fpernice518/Smart-Bike---Senior-Design/Pictures/DSC02479.JPG

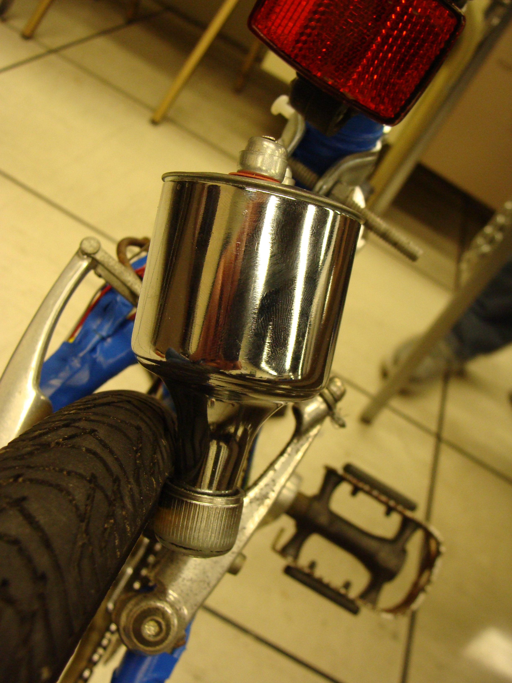
Pictures/DSC02479.JPG
