fpernice518/Smart-Bike---Senior-Design/Pictures/DSC02471.JPG

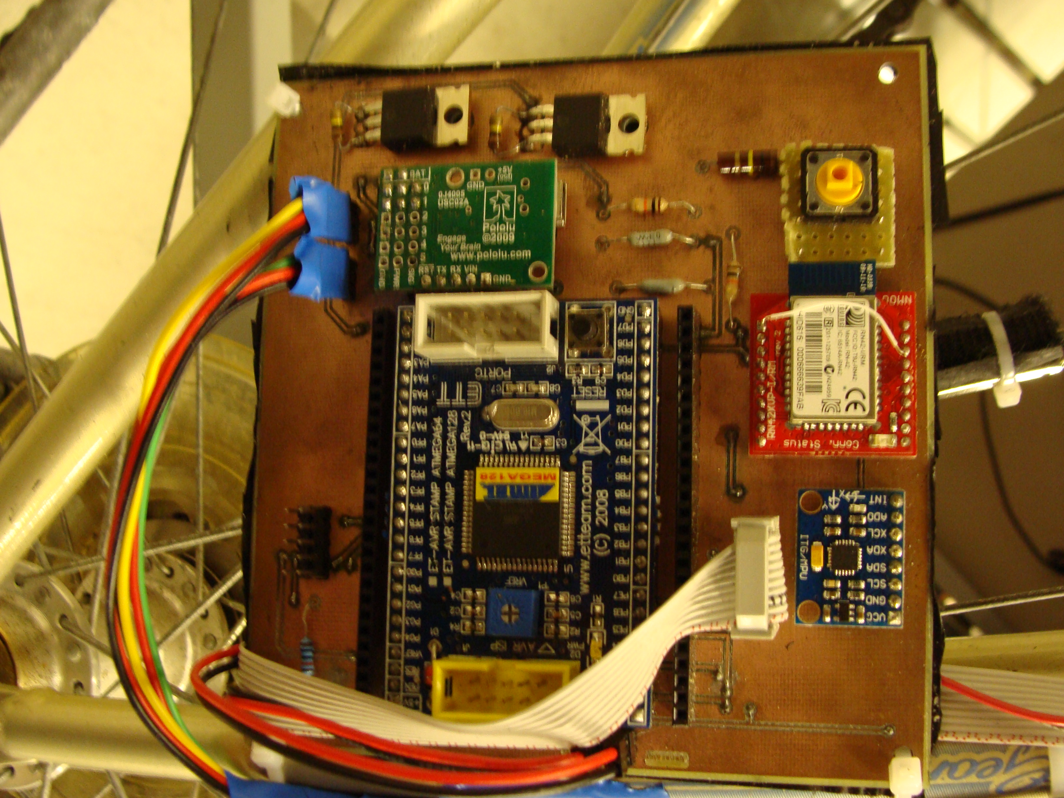
Pictures/DSC02471.JPG
