fpernice518/Smart-Bike---Senior-Design/Android App/README.txt

The included .apk file is the installer for Android phones.
This file should be place don an Android phone and installed
It can also be dowloaded from my website at:
http://frankpernice.com/Projects/SmartBike/SmartBike.apk
Or by scaning the included QR code with a Android phone's camera

The .aia file is the App Inventor file.
To view the block code, follow these steps:
1) visit ai2.appinventor.mit.edu/
2) sign in with a Google account
	- I suppose the school email will now be fine now that it is Gmail based.
3) At the main screen, click Project -> Import Project (.aia) from my computer
