fpernice518/Smart-Bike---Senior-Design/Pictures/DSC02470.JPG

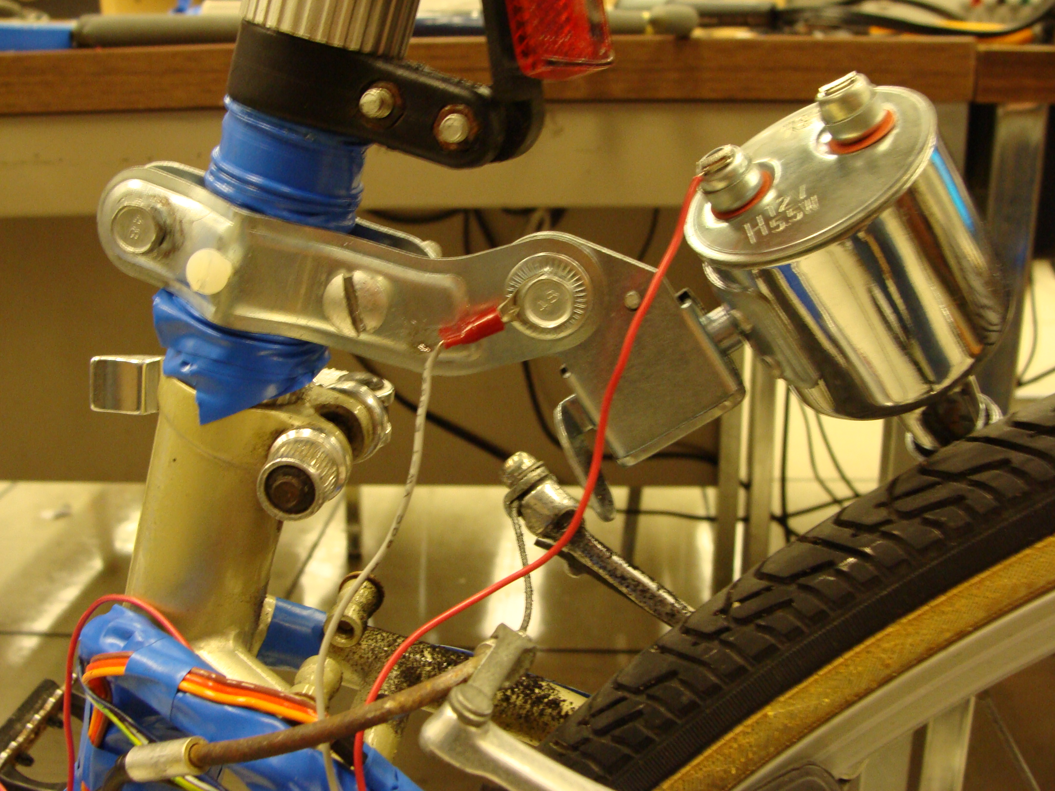
Pictures/DSC02470.JPG
