fpernice518/Smart-Bike---Senior-Design/Pictures/DSC02472.JPG

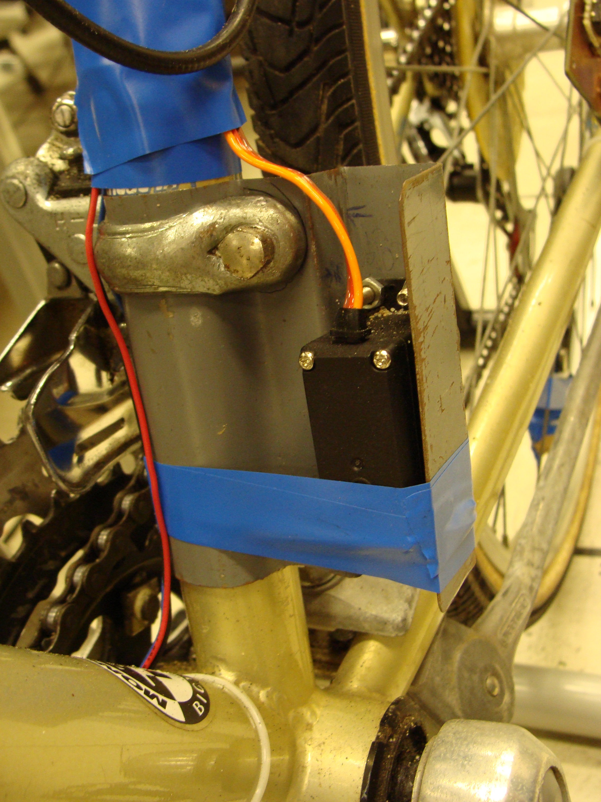
Pictures/DSC02472.JPG
