fpernice518/Smart-Bike---Senior-Design/Pictures/DSC02473.JPG

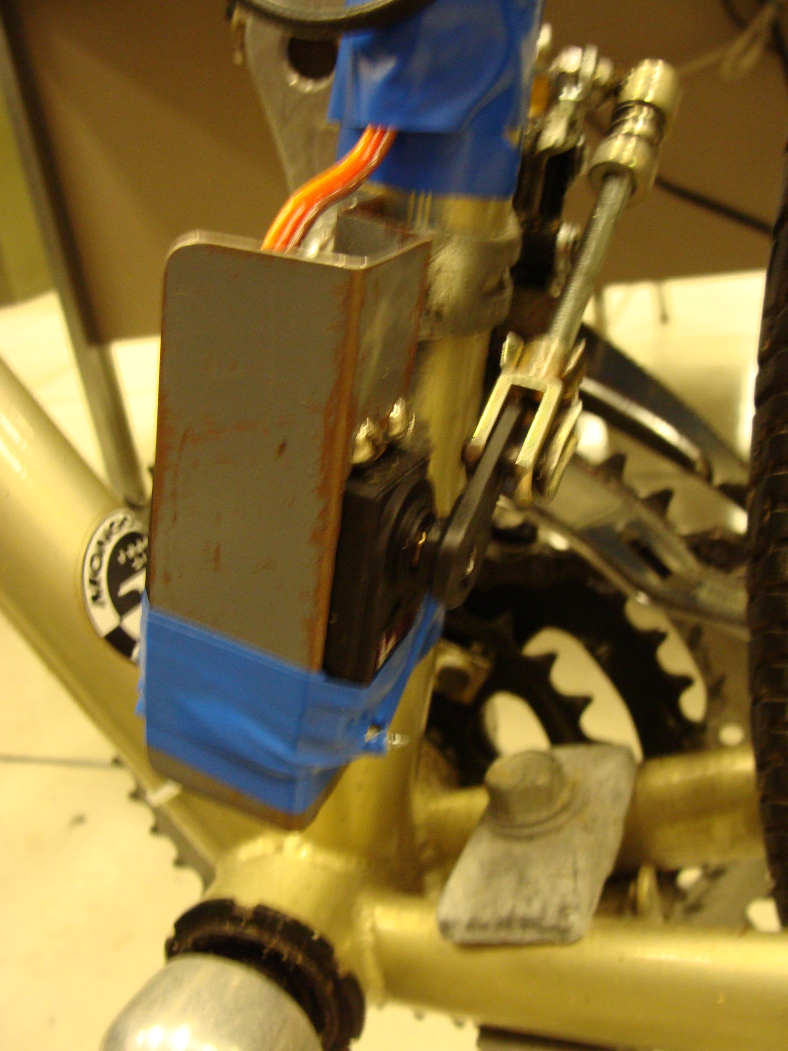
Pictures/DSC02473.JPG
