fpernice518/Smart-Bike---Senior-Design/Pictures/DSC02474.JPG

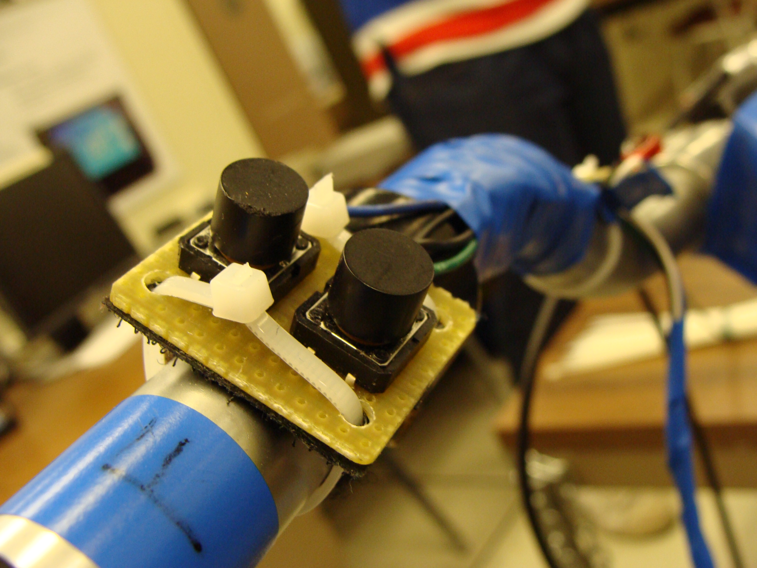
Pictures/DSC02474.JPG
