fpernice518/Smart-Bike---Senior-Design/Pictures/DSC02475.JPG

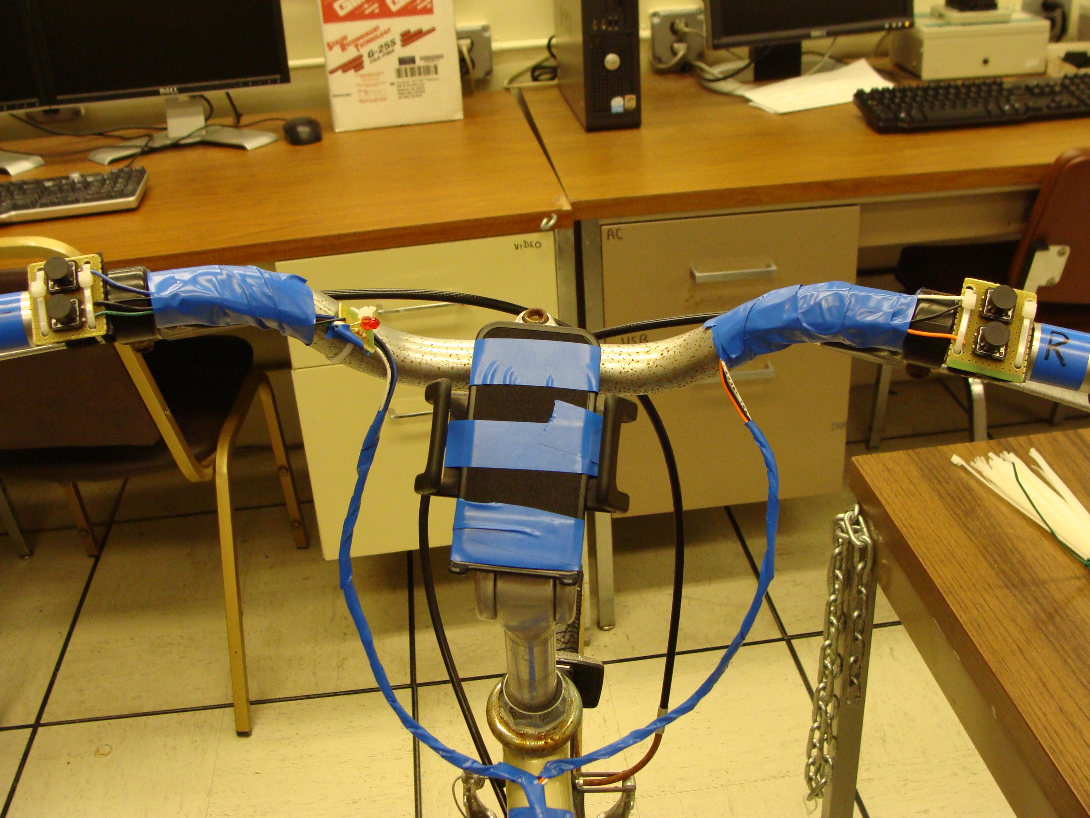
Pictures/DSC02475.JPG
