fpernice518/Smart-Bike---Senior-Design/Pictures/DSC02478.JPG

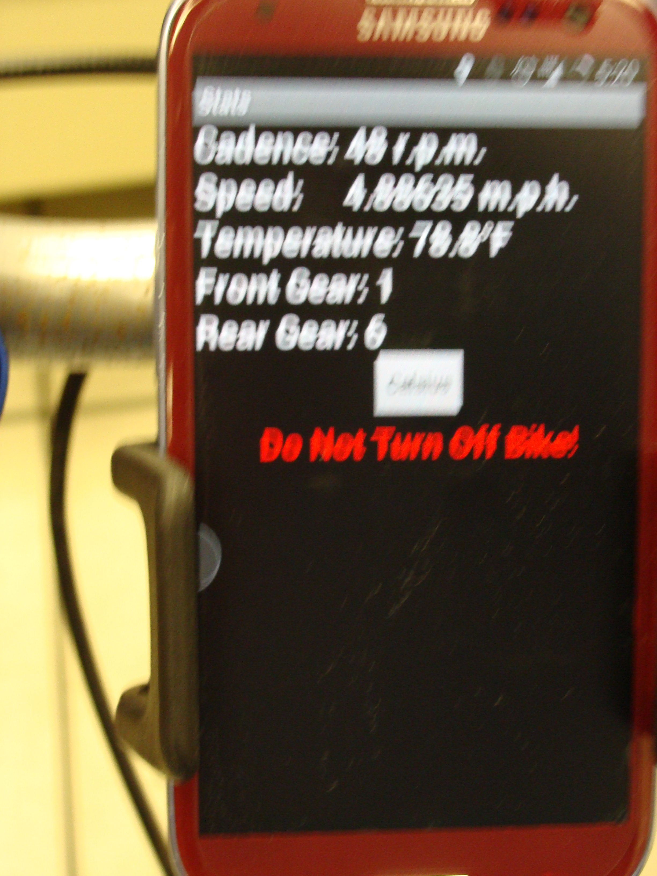
Pictures/DSC02478.JPG
