fpernice518/Smart-Bike---Senior-Design/Pictures/DSC02480.JPG

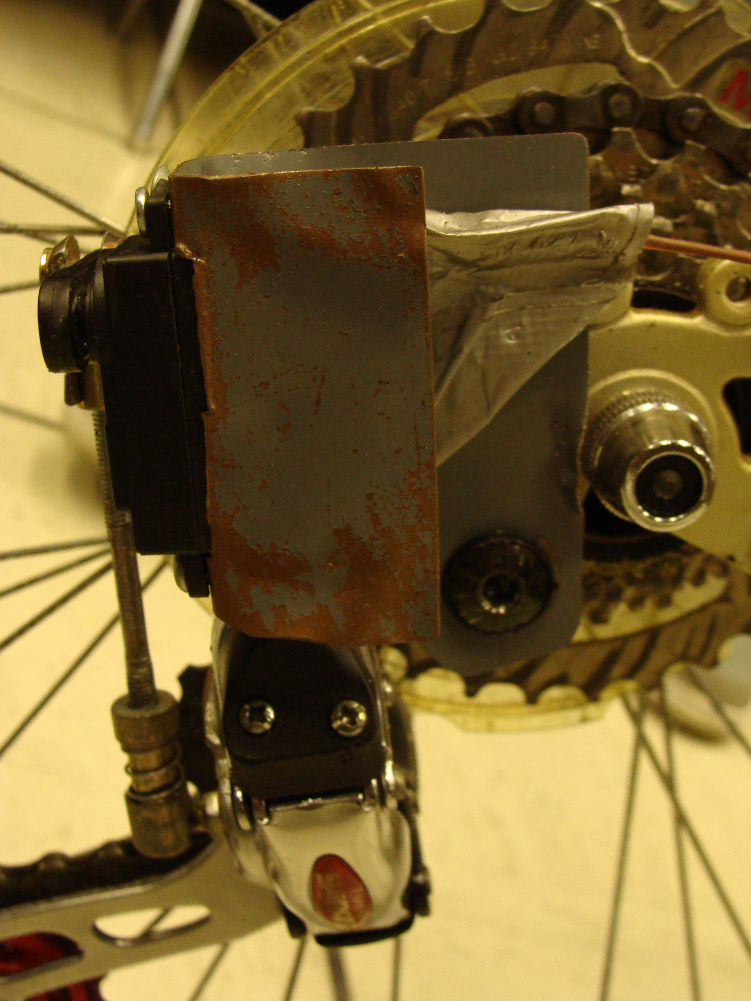
Pictures/DSC02480.JPG
