fpernice518/Smart-Bike---Senior-Design/Pictures/DSC02481.JPG

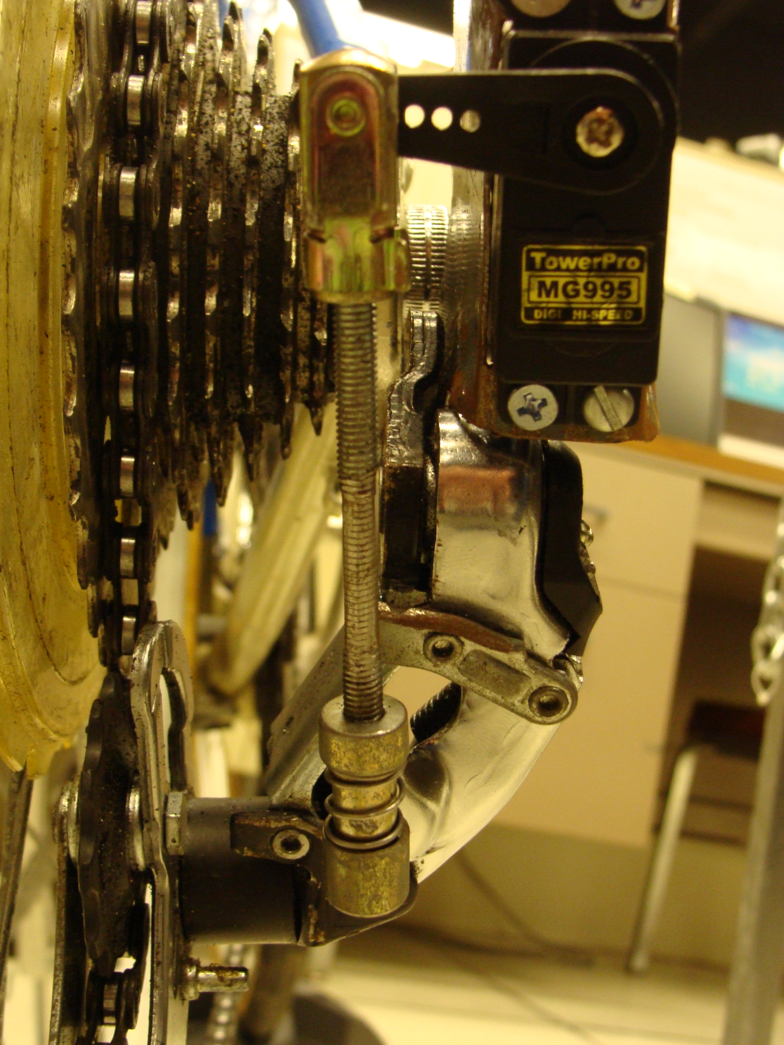
Pictures/DSC02481.JPG
