fpernice518/Smart-Bike---Senior-Design/Pictures/DSC02482.JPG

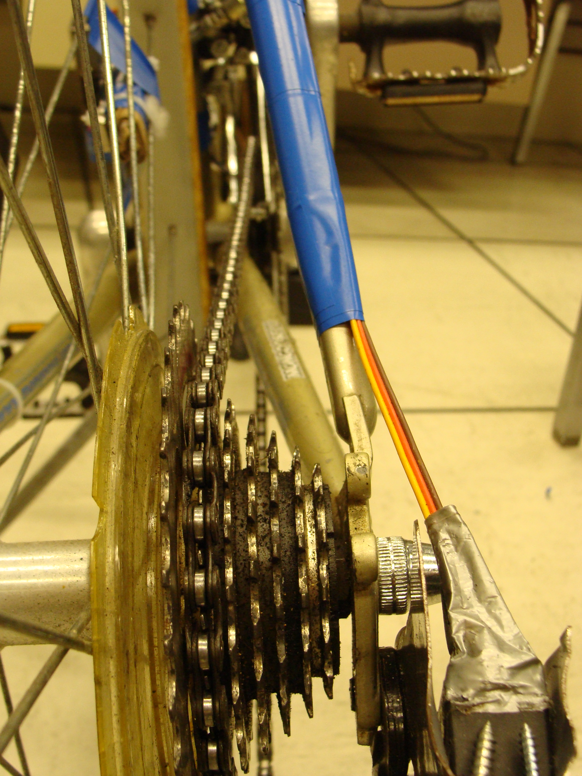
Pictures/DSC02482.JPG
