fpernice518/Smart-Bike---Senior-Design/Pictures/DSC02483.JPG

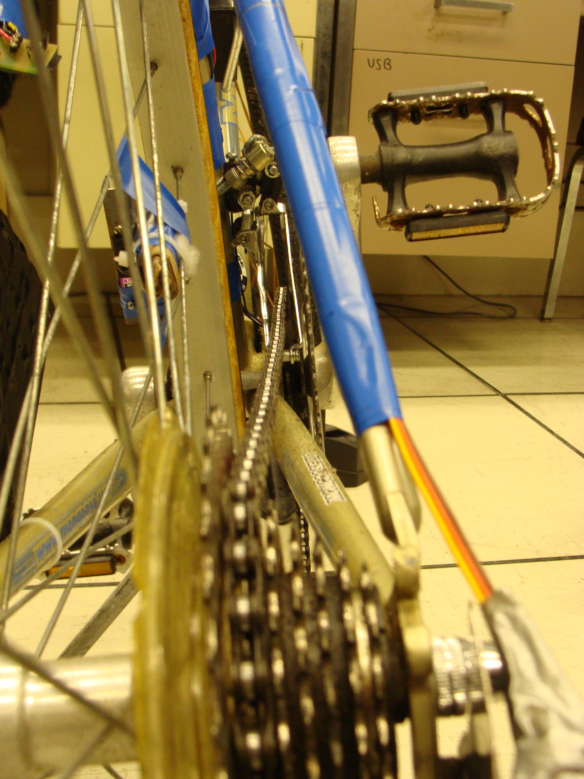
Pictures/DSC02483.JPG
