fpernice518/Smart-Bike---Senior-Design/Pictures/DSC02484.JPG

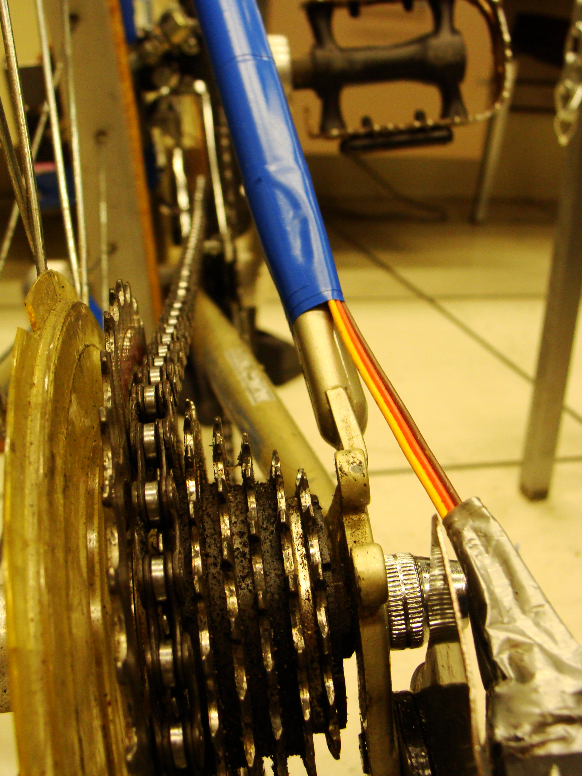
Pictures/DSC02484.JPG
