fpernice518/Smart-Bike---Senior-Design/Pictures/DSC02485.JPG

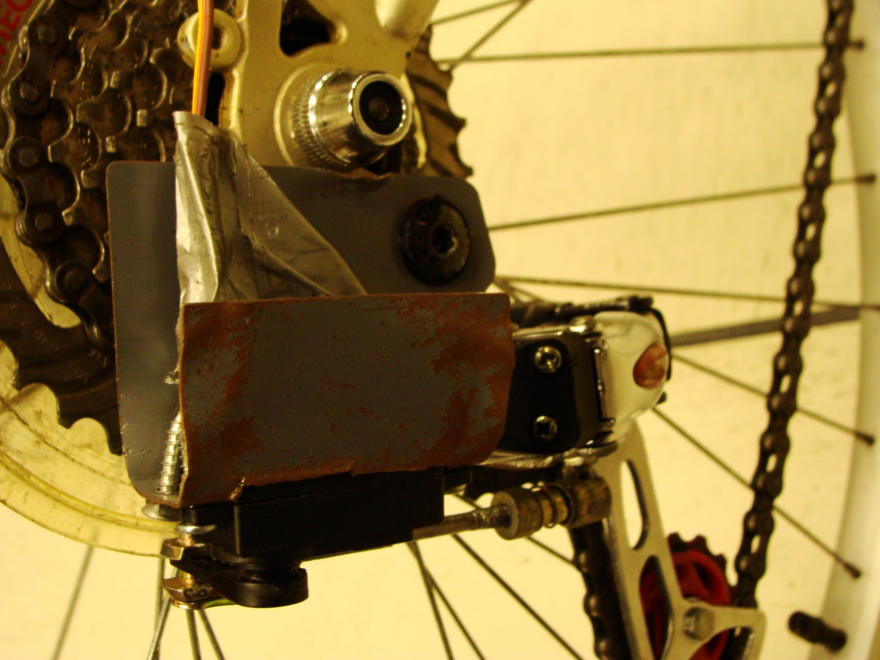
Pictures/DSC02485.JPG
