fpernice518/Smart-Bike---Senior-Design/Pictures/DSC02486.JPG

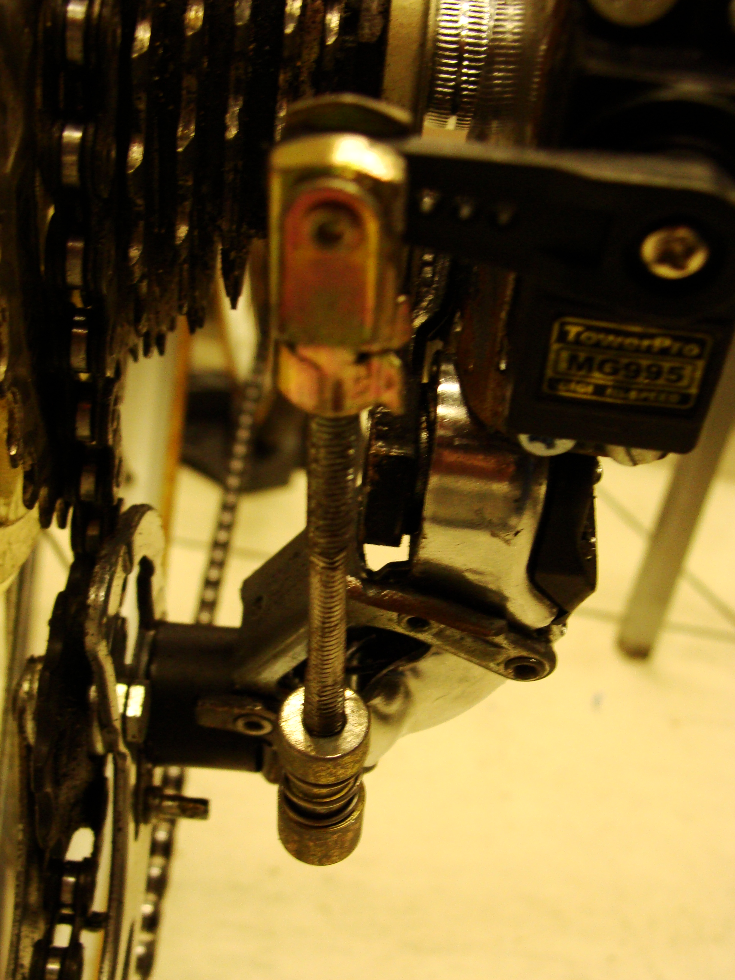
Pictures/DSC02486.JPG
