fpernice518/Smart-Bike---Senior-Design/Pictures/DSC02487.JPG

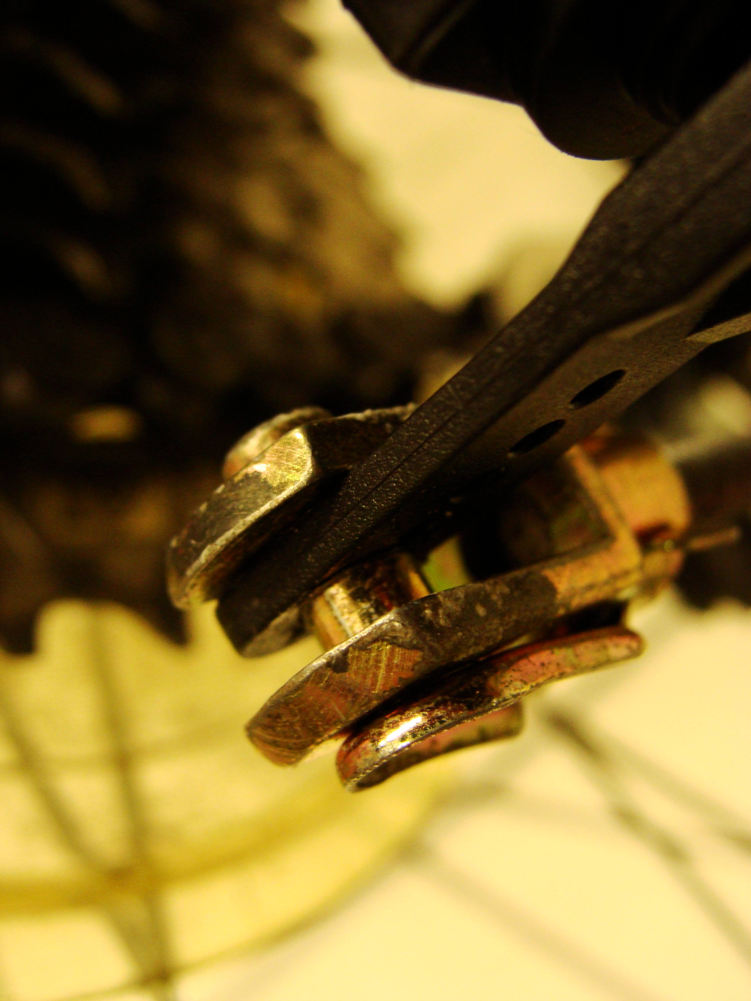
Pictures/DSC02487.JPG
