fpernice518/Smart-Bike---Senior-Design/Pictures/DSC02488.JPG

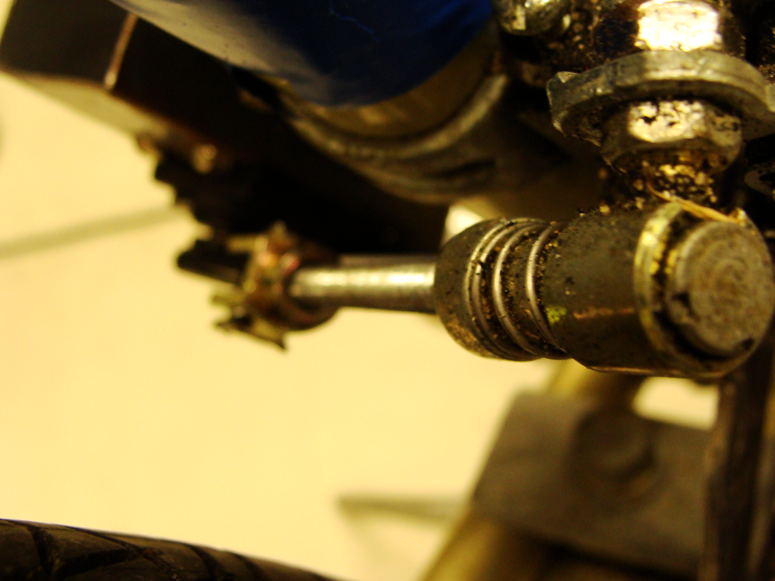
Pictures/DSC02488.JPG
