fpernice518/Smart-Bike---Senior-Design/Pictures/DSC02489.JPG

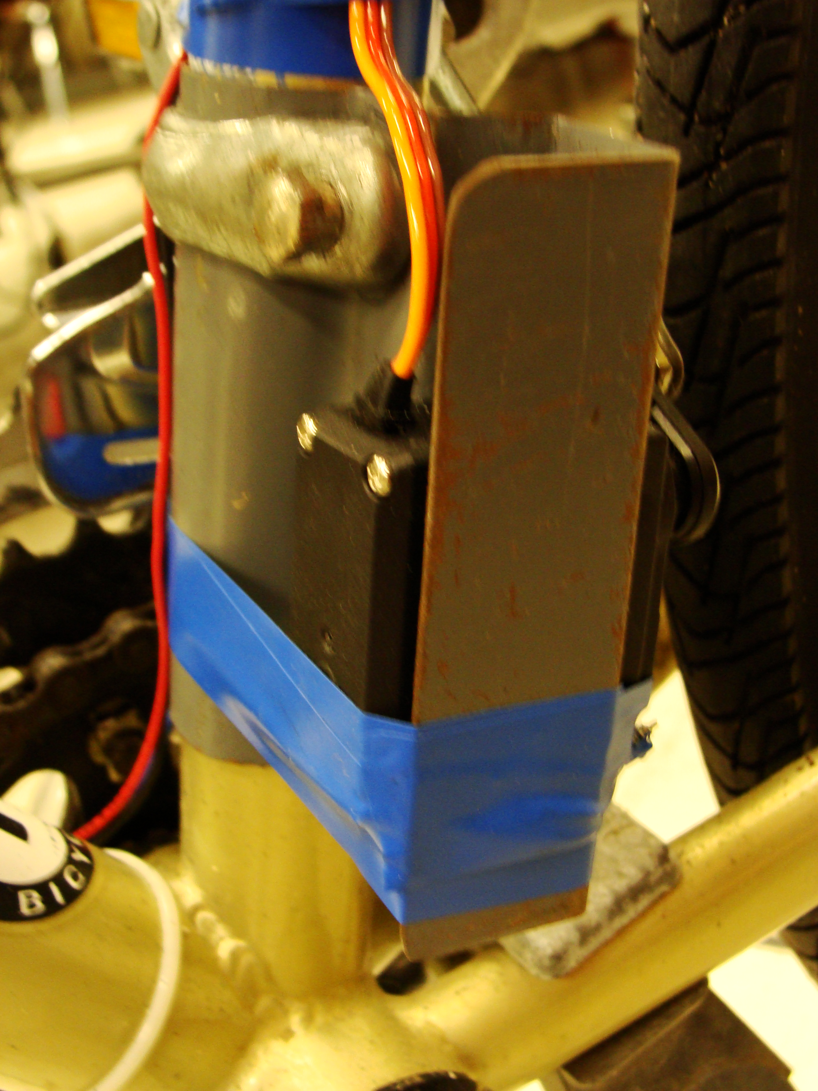
Pictures/DSC02489.JPG
