fpernice518/Smart-Bike---Senior-Design/Pictures/DSC02490.JPG

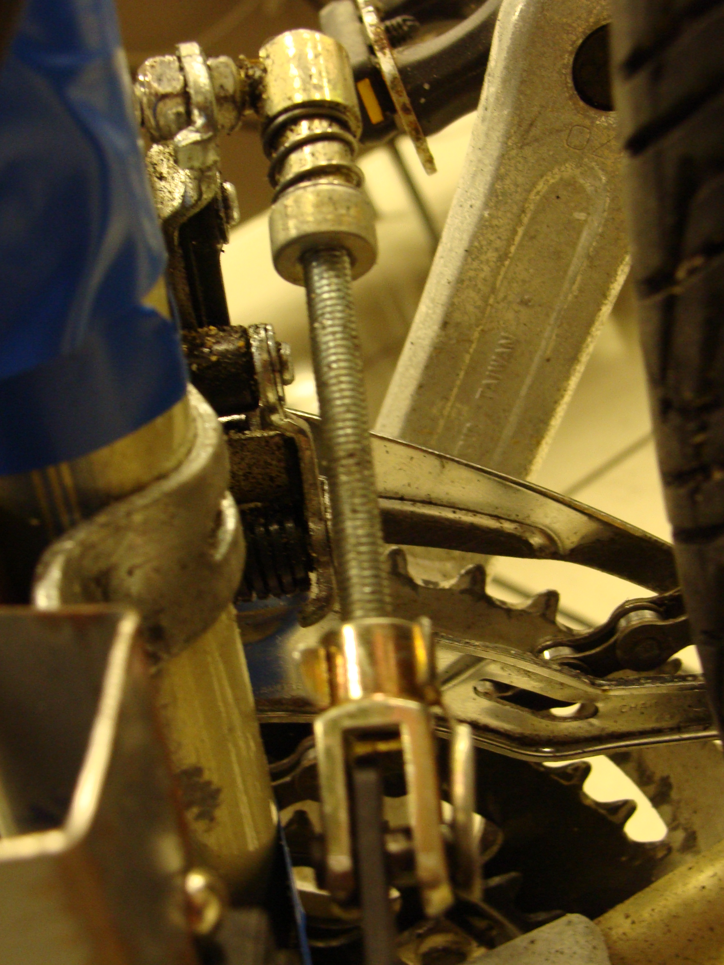
Pictures/DSC02490.JPG
