fpernice518/Smart-Bike---Senior-Design/Pictures/DSC02491.JPG

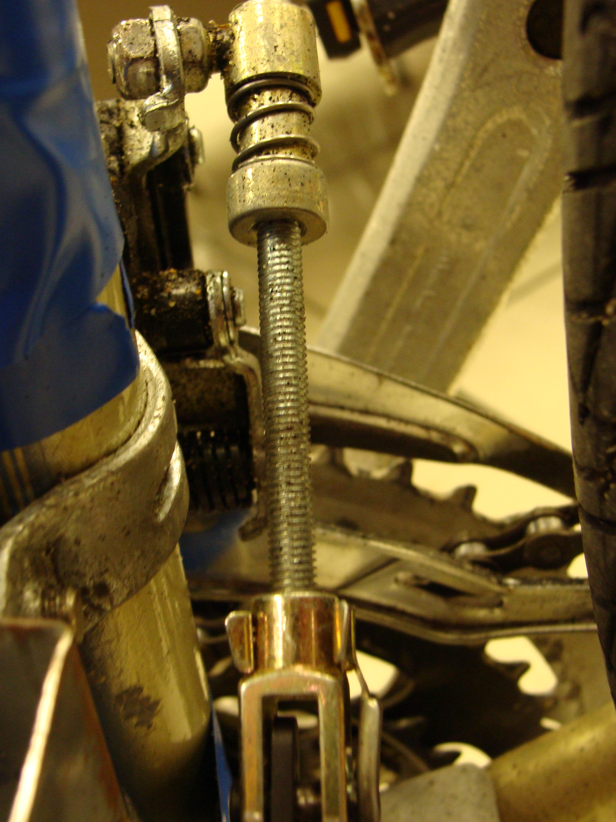
Pictures/DSC02491.JPG
