fpernice518/Smart-Bike---Senior-Design/Pictures/DSC02492.JPG

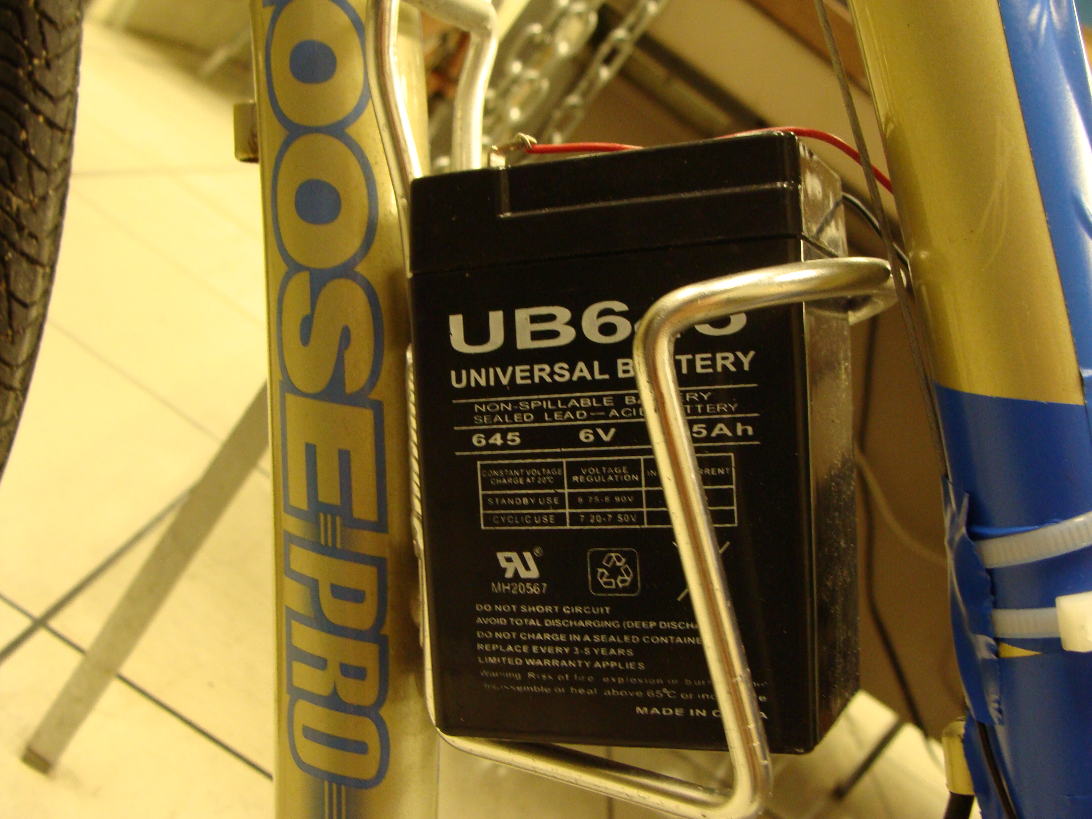
Pictures/DSC02492.JPG
