fpernice518/Smart-Bike---Senior-Design/Pictures/DSC02494.JPG

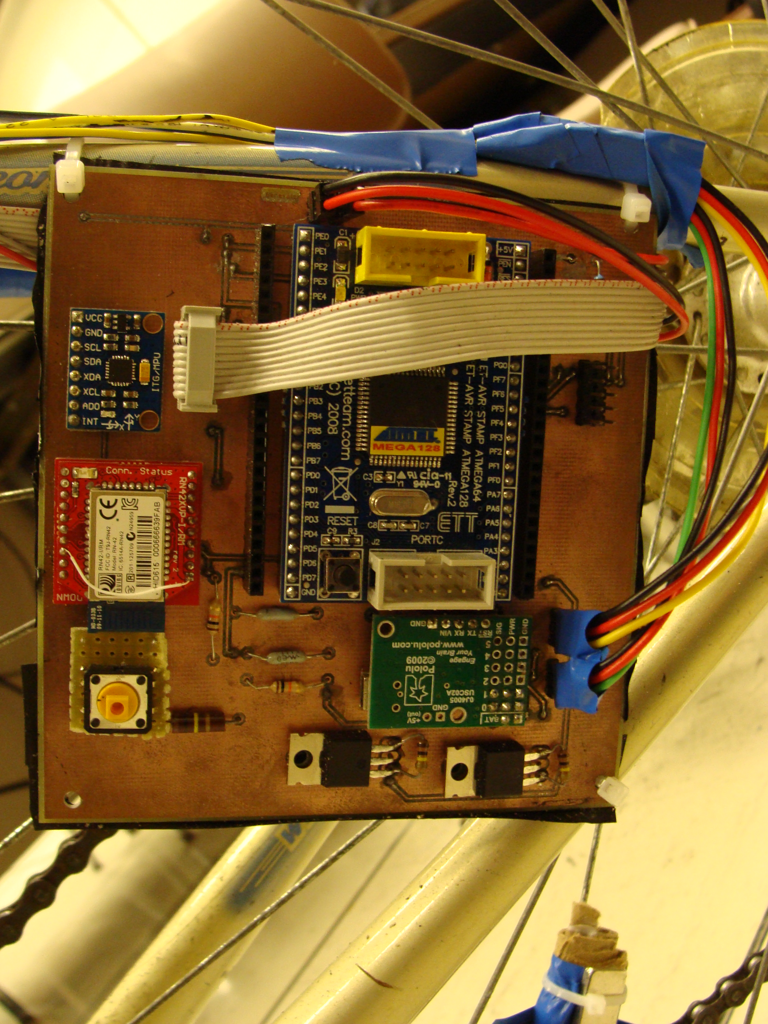
Pictures/DSC02494.JPG
