fpernice518/Smart-Bike---Senior-Design/Pictures/DSC02495.JPG

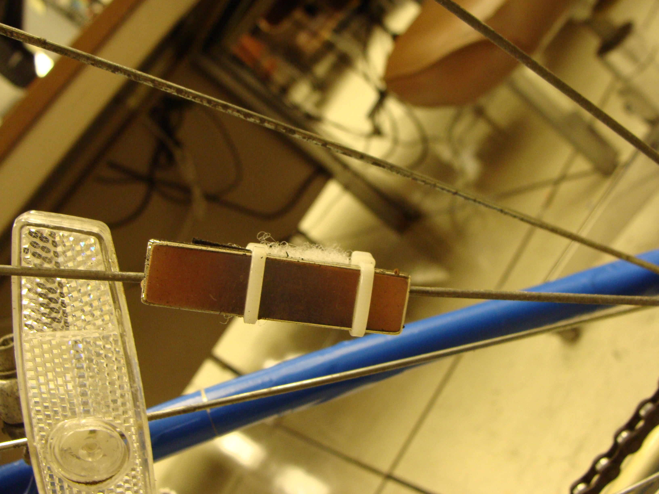
Pictures/DSC02495.JPG
