fpernice518/Smart-Bike---Senior-Design/Pictures/DSC02496.JPG

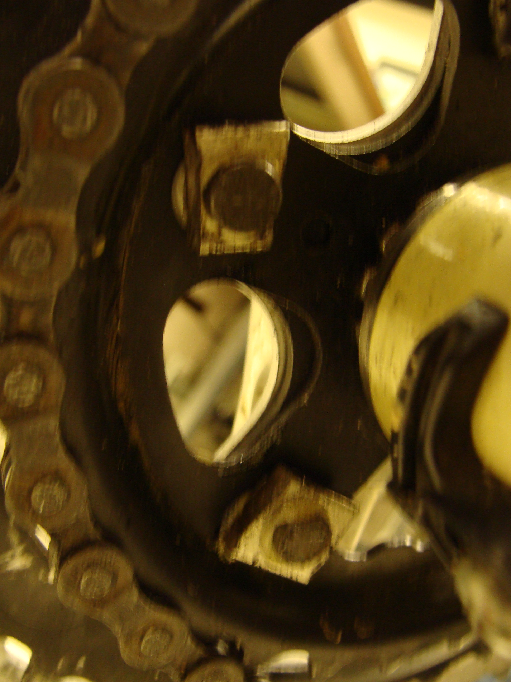
Pictures/DSC02496.JPG
