fpernice518/Smart-Bike---Senior-Design/Pictures/DSC02497.JPG

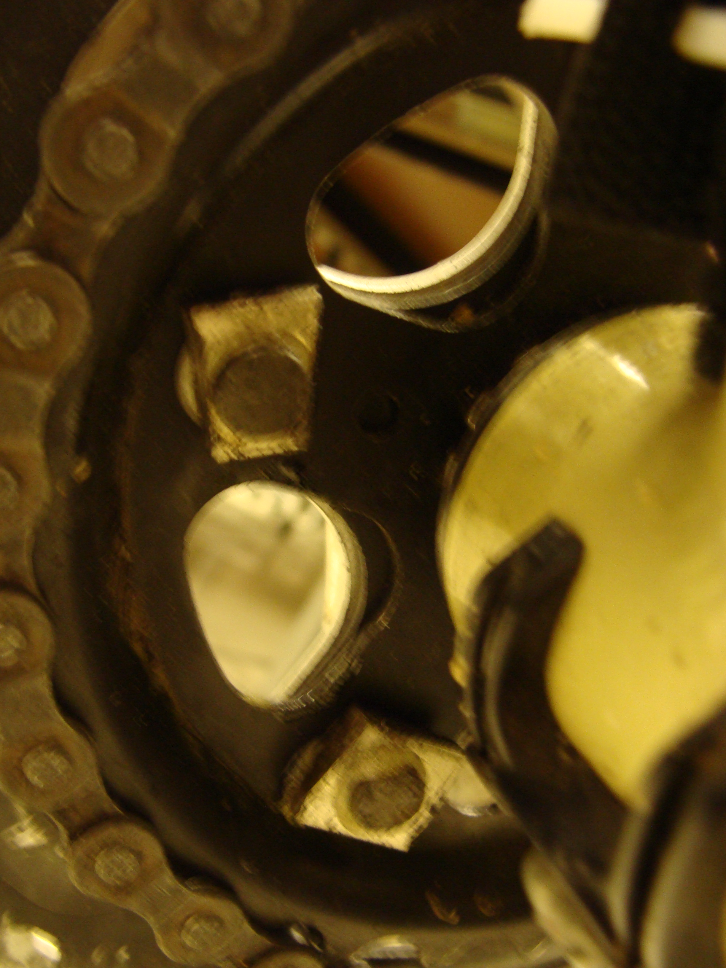
Pictures/DSC02497.JPG
