fpernice518/Smart-Bike---Senior-Design/Pictures/DSC02498.JPG

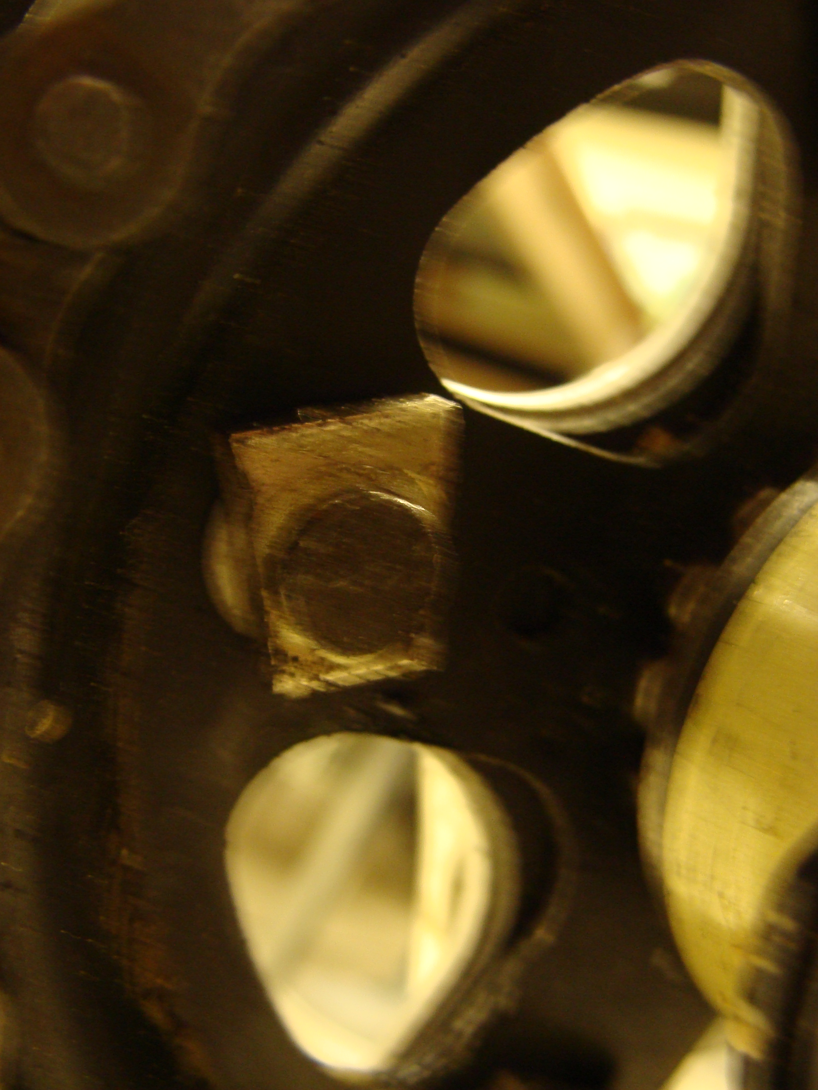
Pictures/DSC02498.JPG
