fpernice518/Smart-Bike---Senior-Design/Pictures/DSC02499.JPG

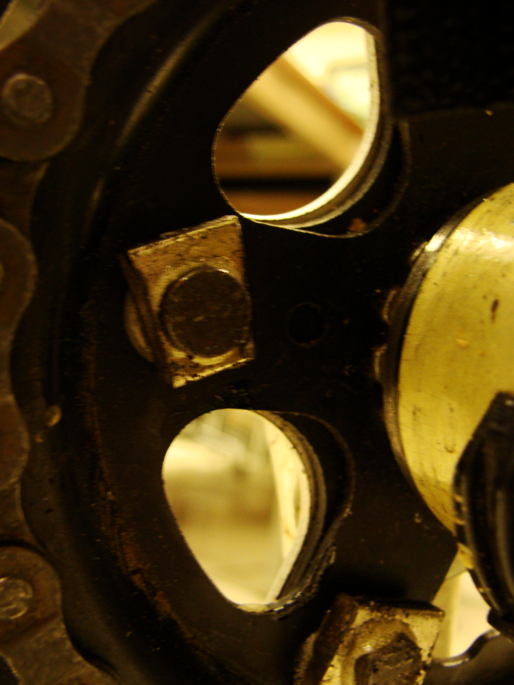
Pictures/DSC02499.JPG
