fpernice518/Smart-Bike---Senior-Design/Pictures/DSC02500.JPG

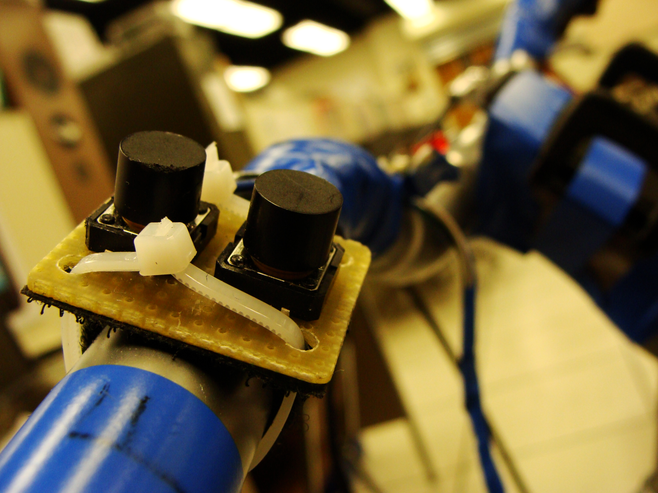
Pictures/DSC02500.JPG
