fpernice518/Smart-Bike---Senior-Design/Pictures/DSC02501.JPG

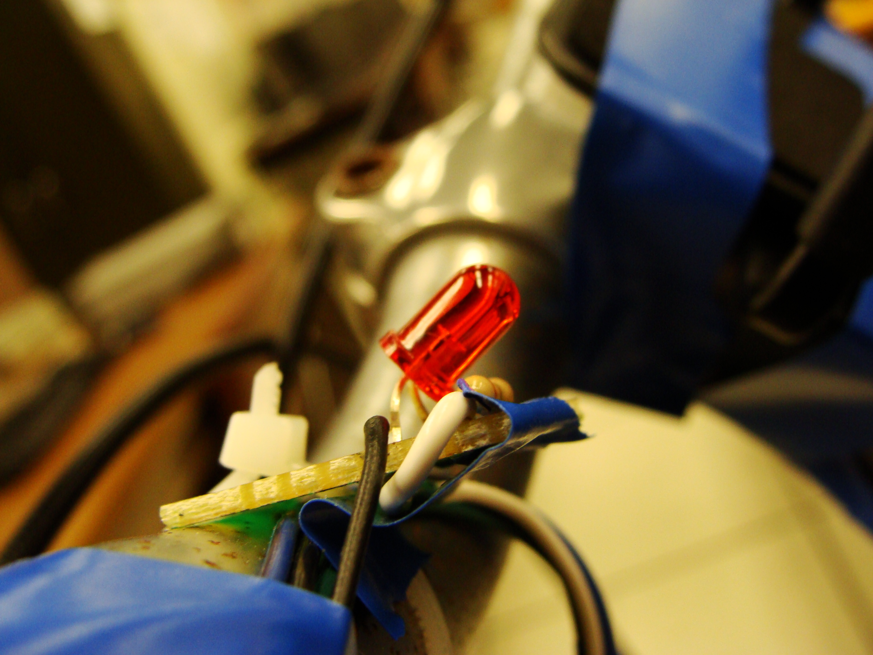
Pictures/DSC02501.JPG
