fpernice518/Smart-Bike---Senior-Design/Pictures/DSC02502.JPG

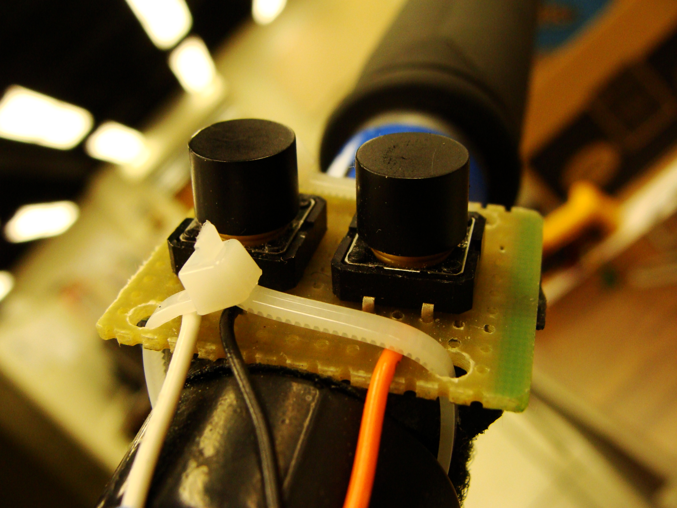
Pictures/DSC02502.JPG
