fpernice518/Smart-Bike---Senior-Design/Pictures/DSC02503.JPG

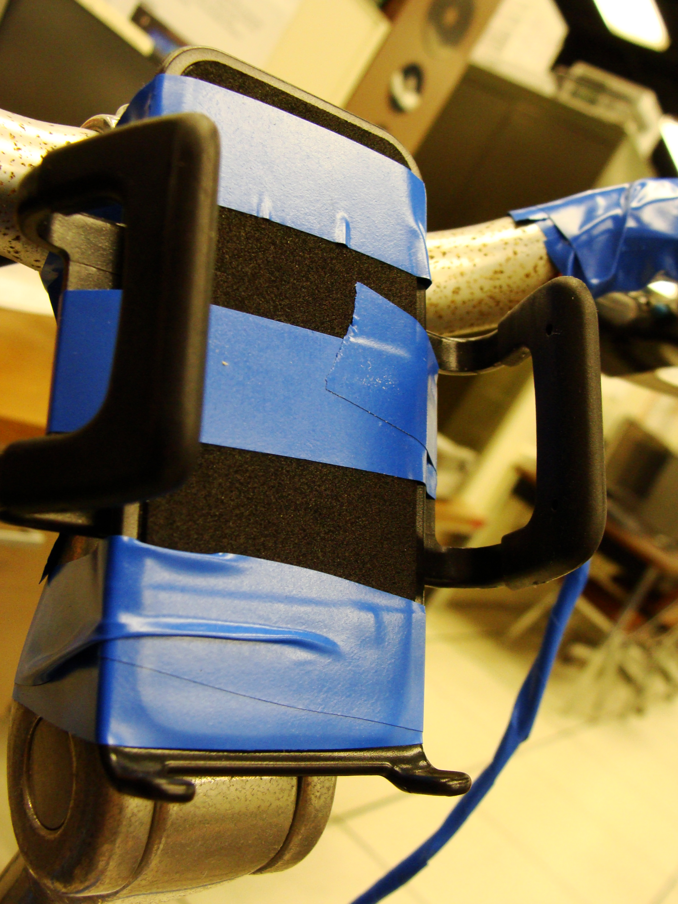
Pictures/DSC02503.JPG
