fpernice518/Smart-Bike---Senior-Design/Pictures/DSC02506.JPG

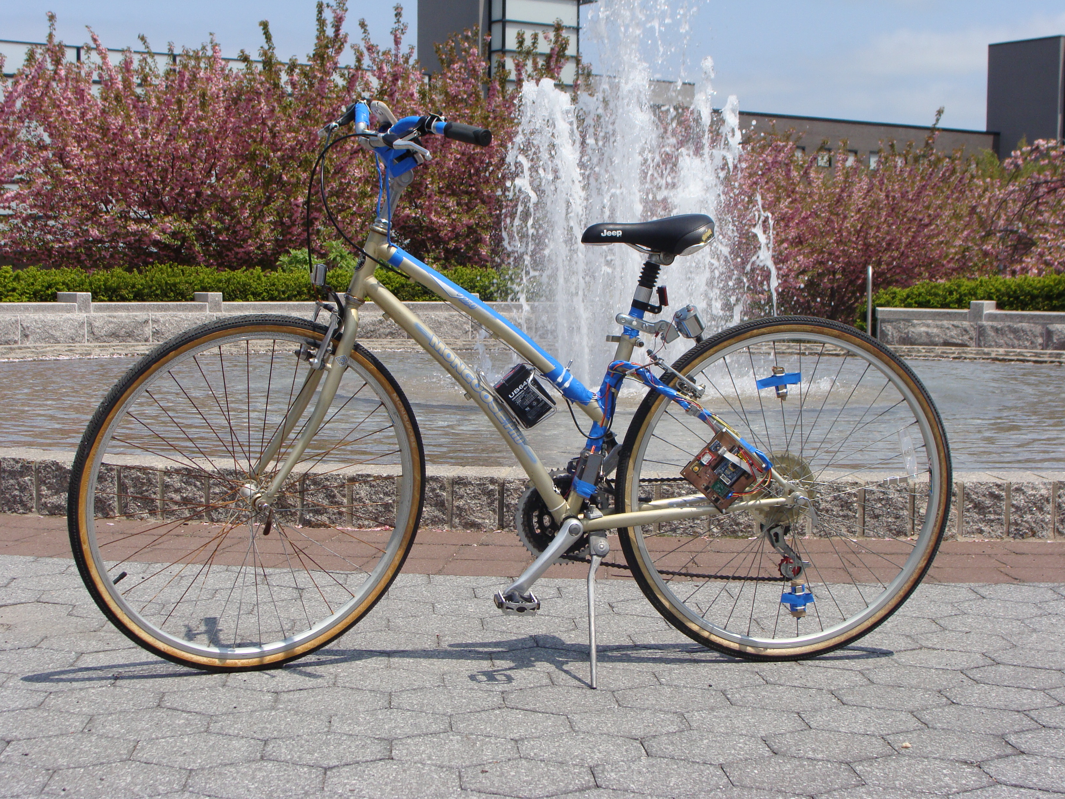
Pictures/DSC02506.JPG
