fpernice518/Smart-Bike---Senior-Design/Pictures/DSC02507.JPG

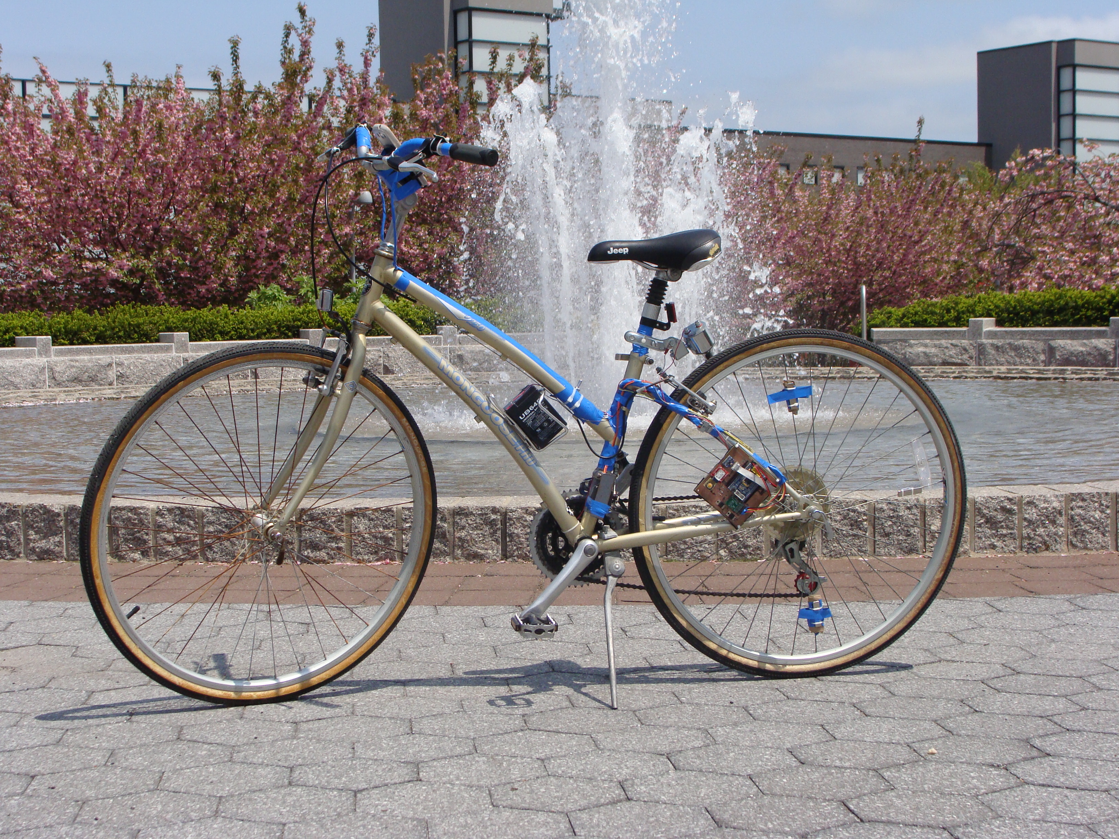
Pictures/DSC02507.JPG
