fpernice518/Smart-Bike---Senior-Design/Pictures/DSC02508.JPG

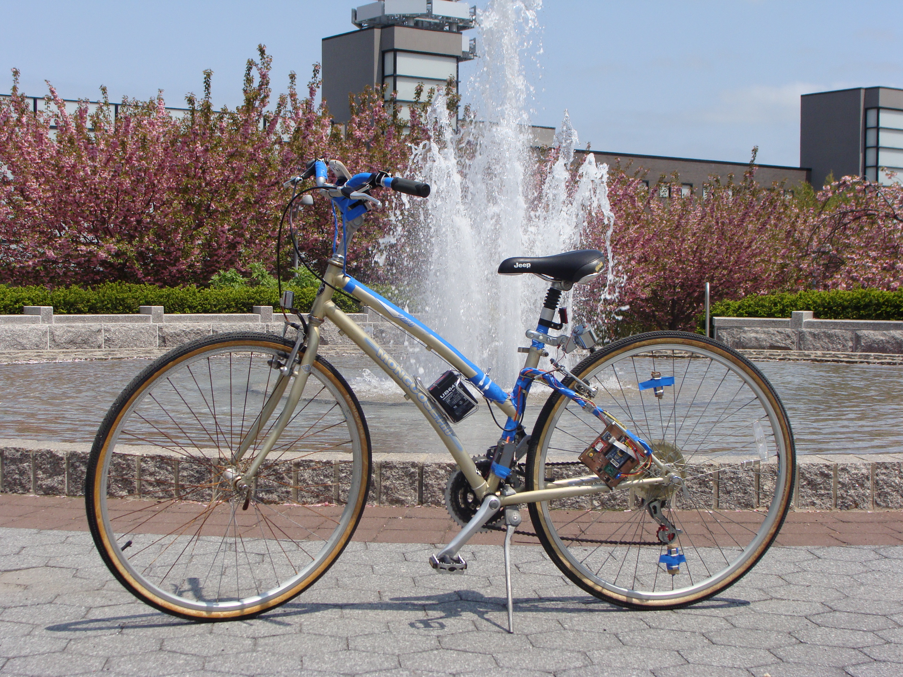
Pictures/DSC02508.JPG
