fpernice518/Smart-Bike---Senior-Design/Pictures/DSC02509.JPG

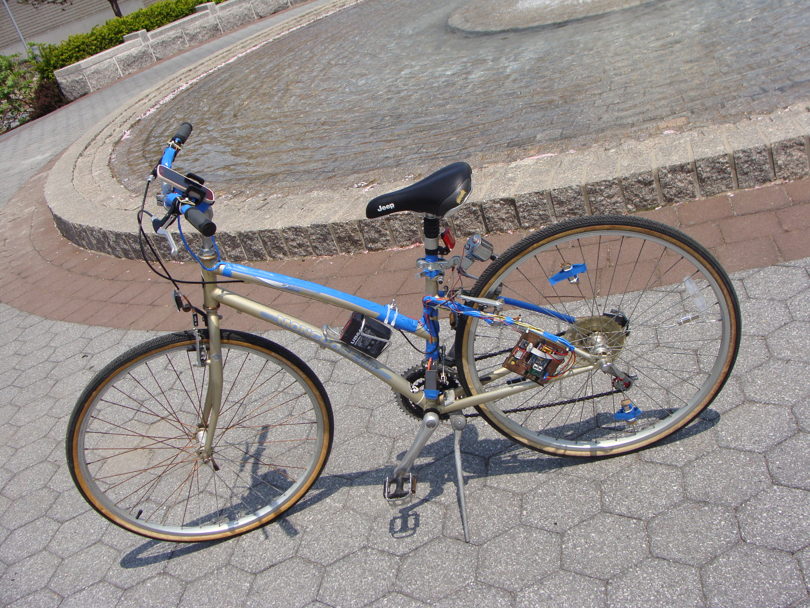
Pictures/DSC02509.JPG
