fpernice518/Smart-Bike---Senior-Design/Pictures/DSC02510.JPG

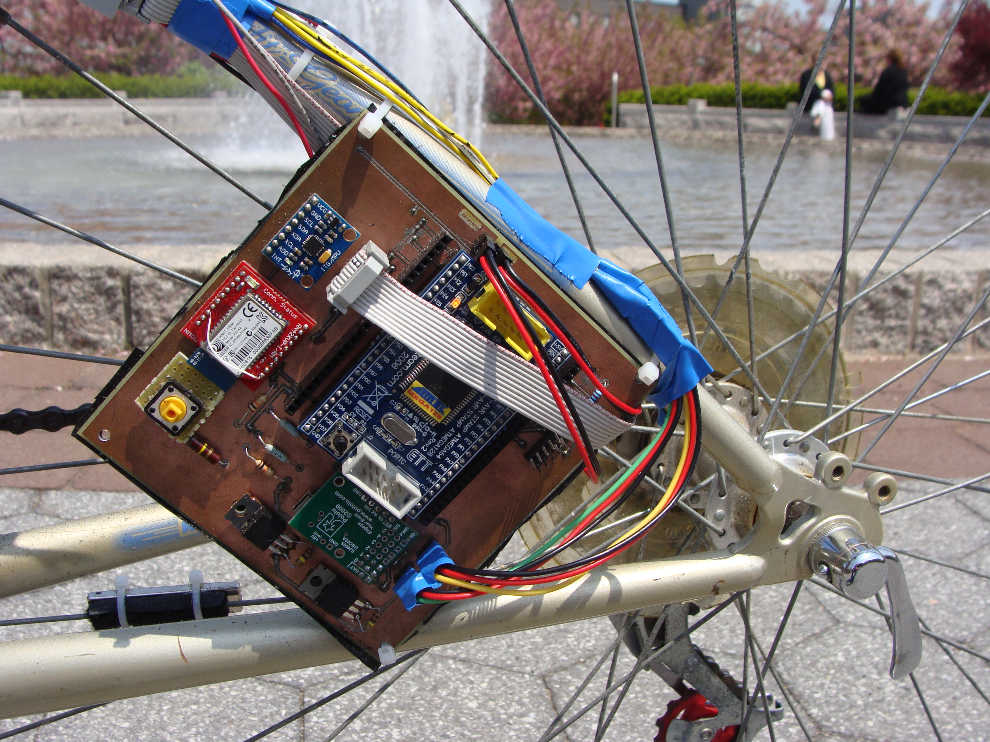
Pictures/DSC02510.JPG
