fpernice518/Smart-Bike---Senior-Design/Pictures/DSC02511.JPG

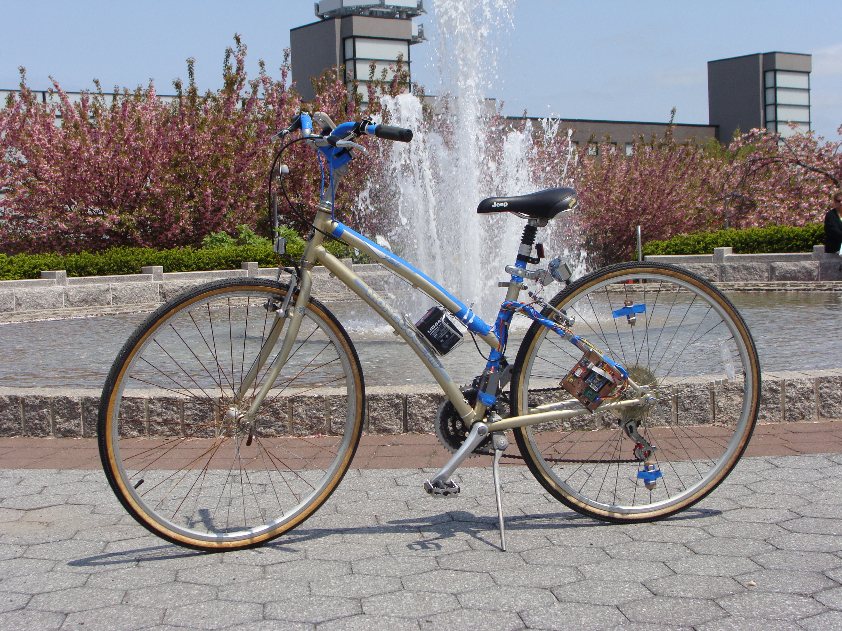
Pictures/DSC02511.JPG
