fpernice518/Smart-Bike---Senior-Design/Pictures/DSC02512.JPG

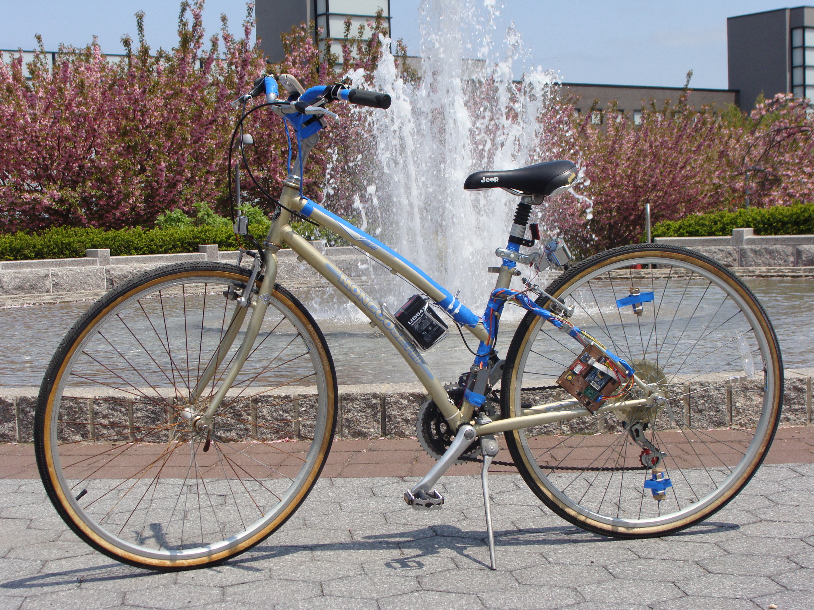
Pictures/DSC02512.JPG
