fpernice518/Smart-Bike---Senior-Design/Schematics/PCB.pdf

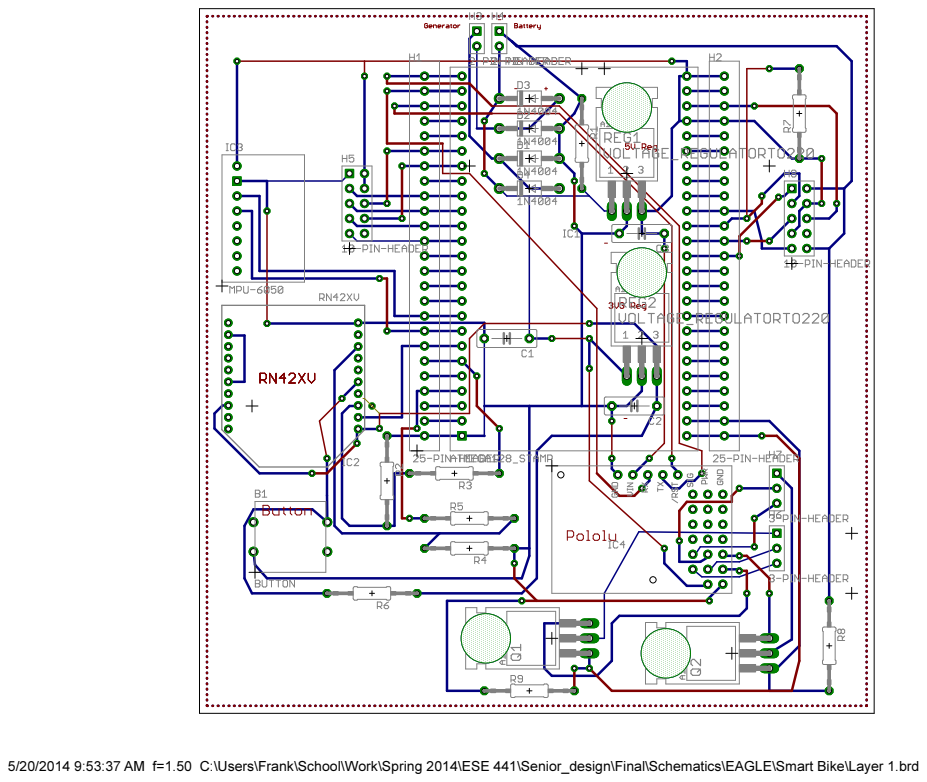
[picture p86: page 1]

5/20/2014 9:53:37 AM f=1.50 C:\Users\Frank\School\Work\Spring 2014\ESE 441\Senior_design\Final\Schematics\EAGLE\Smart Bike\Layer 1.brd
