fpernice518/Smart-Bike---Senior-Design/Schematics/System.pdf

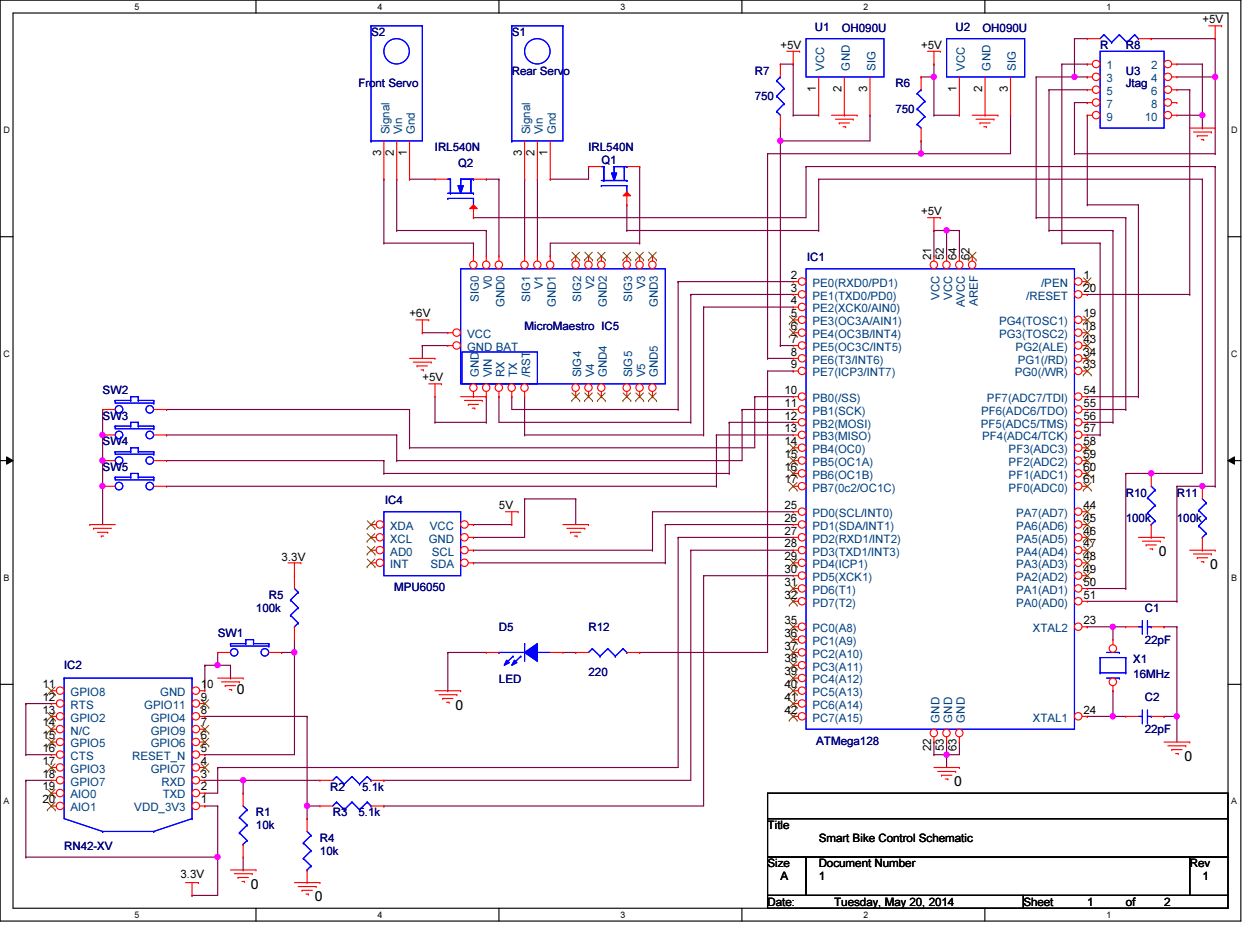
[picture p87: page 1]

5 6 7

Smart Bike Control Schematic
