fpernice518/Smart-Bike---Senior-Design/Schematics/Power.pdf

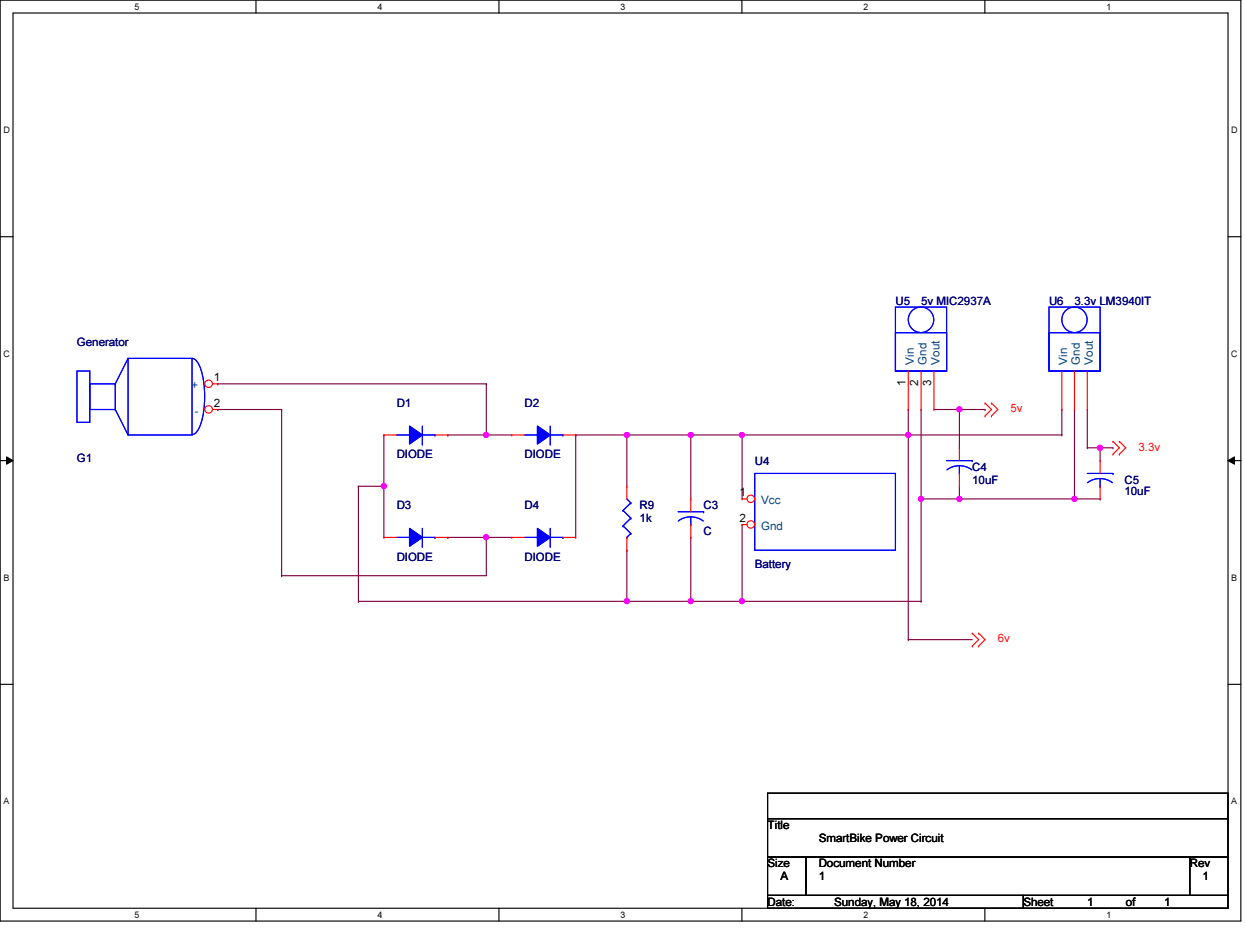
[picture p88: page 1]
