fpernice518/Smart-Bike---Senior-Design/(list of files, drawings)

Other design files:
Schematics/OrCad/SENIOR DESIGN.DSN
Schematics/OrCad/Senior Design.opj
Schematics/OrCad/SMARTBIKELIBRARY.OLB
